james7x1/CPGR4233-PCB-Project/README.md

# CPGR4233-PCB-Project
Voltmeter PCB design project for LeTourneau University CPGR4233.

Derived from 20+ years of PCB designs created by Intro to Microcomputer Design TAs.
Recent Contributors:

Rev 5 - Samuel Johnson, Allen Morrison, Joshua Allen (AJ)

Rev 4 - Samuel Johnson

Rev 3 - Jackson Miller
