james7x1/CPGR4233-PCB-Project/Fabrication/V4/Schematic.pdf

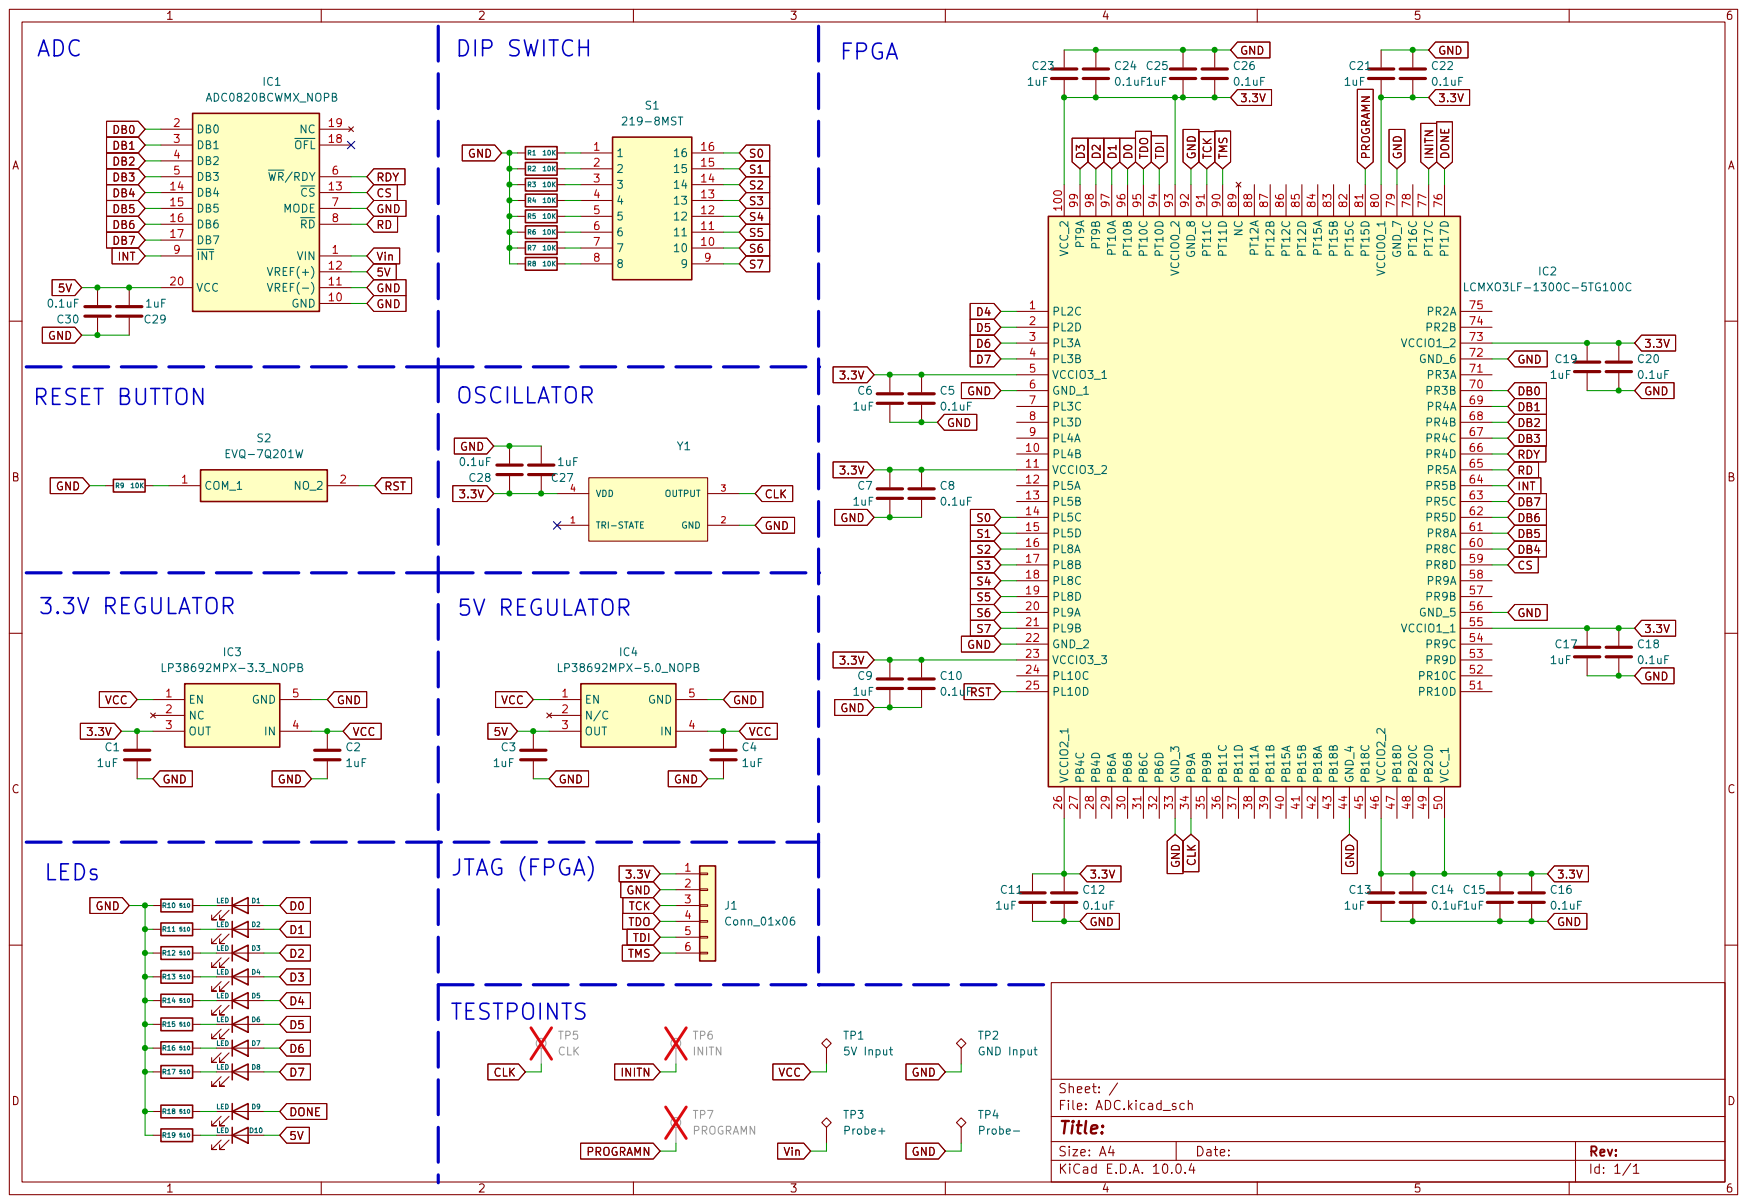
[picture p1: page 1]
