james7x1/CPGR4233-PCB-Project/ADC.kicad_pcb

## KiCad design ADC.kicad_pcb (2026-09-28)

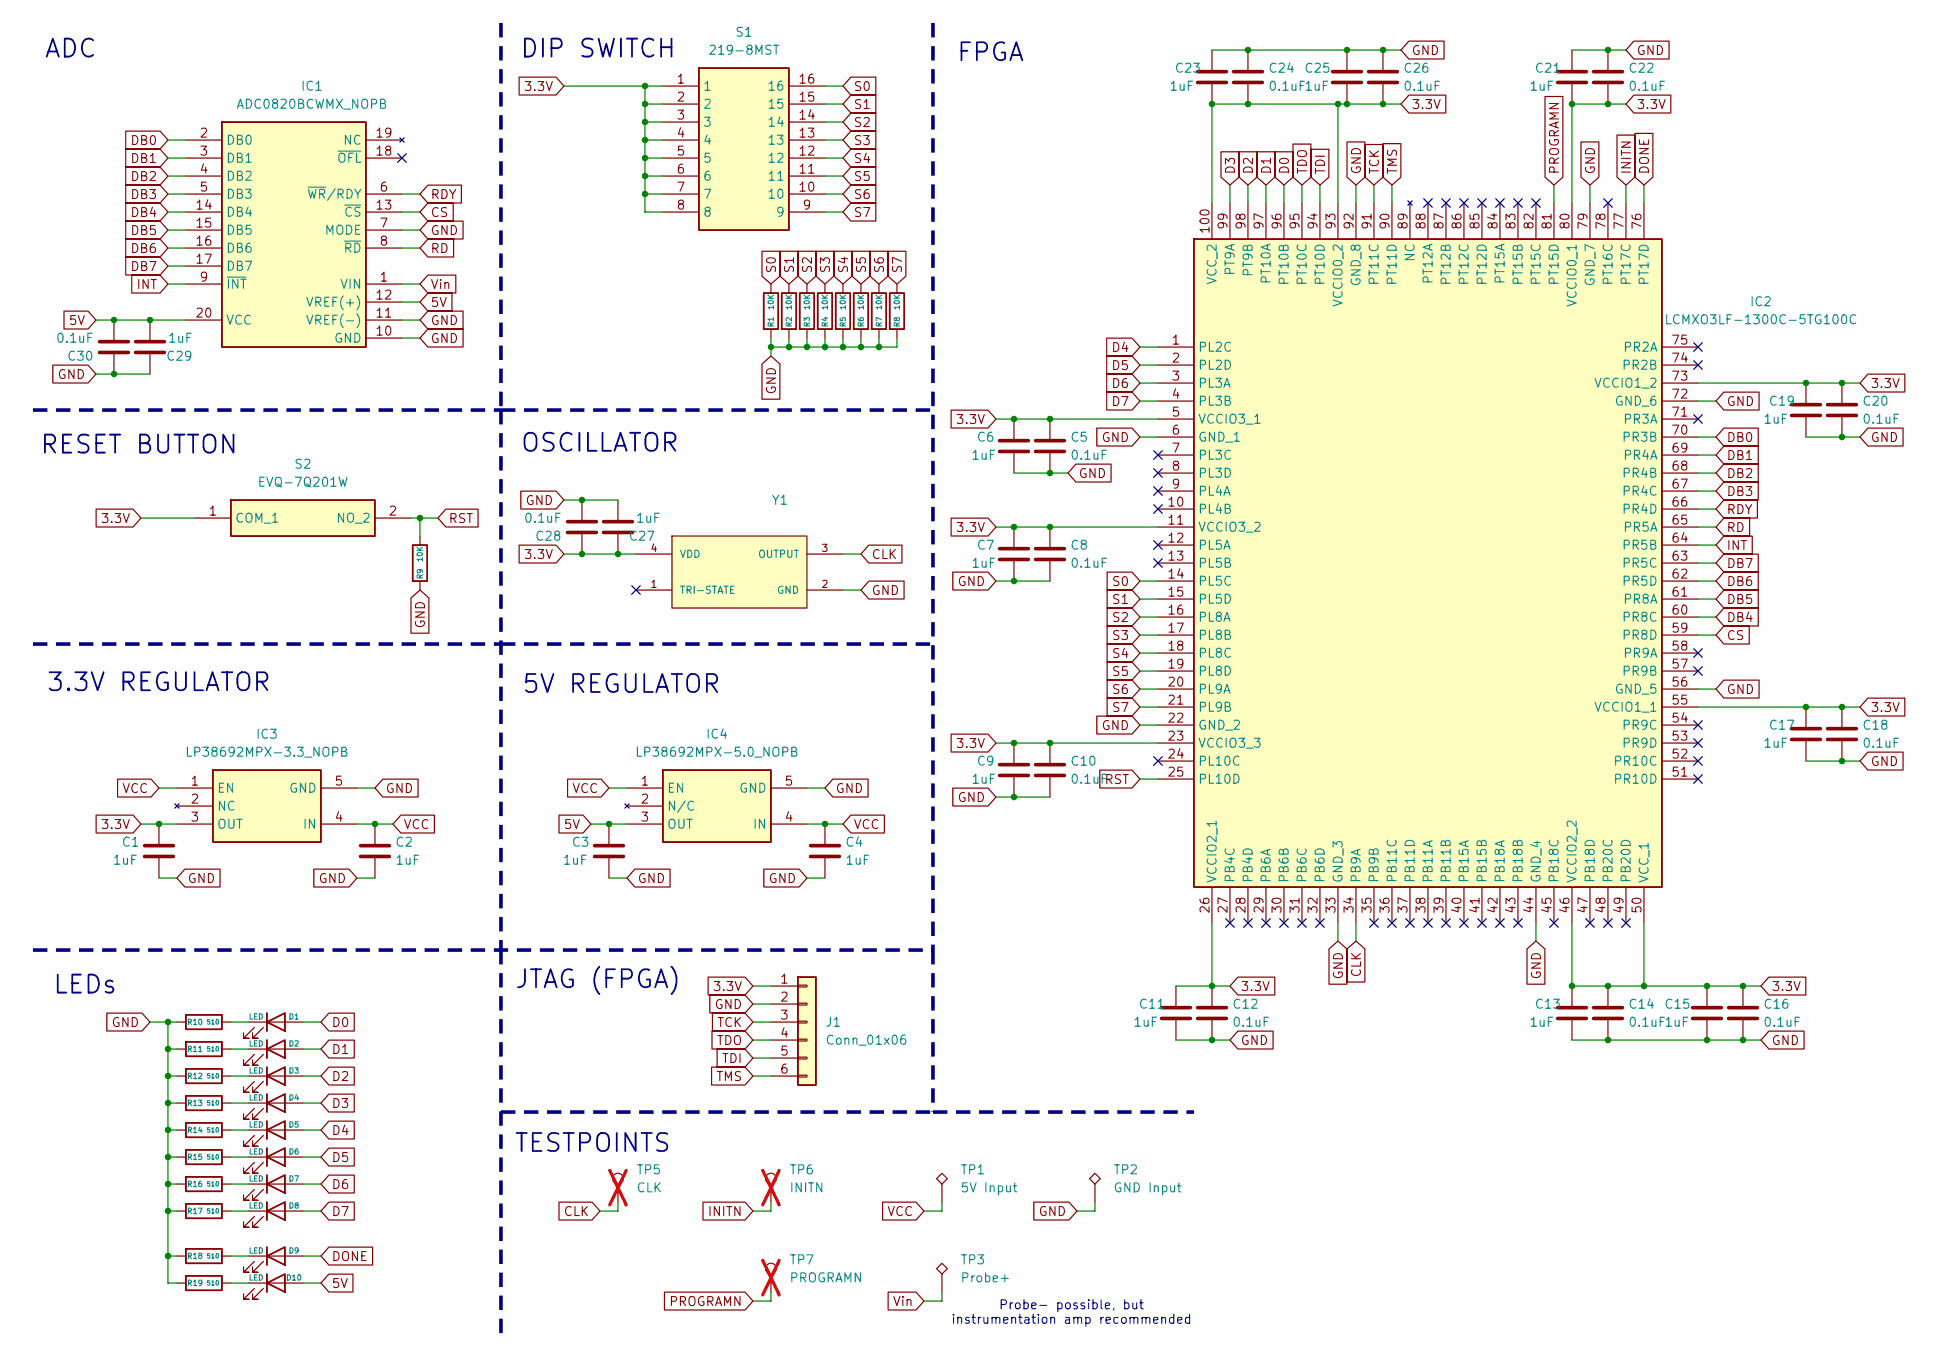
[picture p2: schematic ADC.kicad_sch, CPGR4233 Voltmeter Project]

Parts:
C1, C2, C3, C4, C6, C7, C9, C11, C13, C15, C17, C19, C21, C23, C25, C27, C29: 1uF; C_0805_2012Metric_Pad1.18x1.45mm_HandSolder; Manufacturer_Part_Number GRM21BR71A105MA01L
C5, C8, C10, C12, C14, C16, C18, C20, C22, C24, C26, C28, C30: 0.1uF; C_0805_2012Metric_Pad1.18x1.45mm_HandSolder; Manufacturer_Part_Number GJ4216C81E104JA01D
D1, D2, D3, D4, D5, D6, D7, D8, D9, D10: LED; LED_0805_2012Metric_Pad1.15x1.40mm_HandSolder; Manufacturer_Part_Number 150080GS75000
IC1: ADC0820BCWMX_NOPB; SOIC-20W_7.5x12.8mm_P1.27mm; Mouser Part Number 926-ADC0820BCWMXNOPB
IC2: LCMXO3LF-1300C-5TG100C; TQFP-100_14x14mm_P0.5mm; Mouser Part Number 842-O3LF1300C5TG100C
IC3: LP38692MPX-3.3_NOPB; SOT-223-5; Mouser Part Number 926-LP38692MPX33NOPB
IC4: LP38692MPX-5.0_NOPB; SOT-223-5; Mouser Part Number 926-LP38692MPX50NOPB
J1: Conn_01x06; PinHeader_1x06_P2.54mm_Vertical; Manufacturer_Part_Number G800W302018EU
R1, R2, R3, R4, R5, R6, R7, R8, R9: 10K; R_0805_2012Metric_Pad1.20x1.40mm_HandSolder; Manufacturer_Part_Number AC0805FR-7W10KL
R10, R11, R12, R13, R14, R15, R16, R17, R18, R19: 510; R_0805_2012Metric_Pad1.20x1.40mm_HandSolder; Manufacturer_Part_Number ERJ-PB6D5100V
S1: 219-8MST; SW_DIP_SPSTx08_Slide_6.7x21.88mm_W8.61mm_P2.54mm_LowProfile; Mouser Part Number 774-2198MST
S2: EVQ-7Q201W; SW_SPST_EVQQ2; Mouser Part Number 667-EVQ-7Q201W
TP1: 5V Input; TestPoint_THTPad_2.5x2.5mm_Drill1.2mm; Manufacturer_Part_Number 4952
TP2: GND Input; TestPoint_THTPad_2.5x2.5mm_Drill1.2mm; Manufacturer_Part_Number 4952
TP3: Probe+; TestPoint_THTPad_2.5x2.5mm_Drill1.2mm; Manufacturer_Part_Number 4952
TP5: CLK; TestPoint_Pad_1.5x1.5mm; not fitted
TP6: INITN; TestPoint_Pad_1.5x1.5mm; not fitted
TP7: PROGRAMN; TestPoint_Pad_1.5x1.5mm; not fitted
Y1: CDFN-4_3.2x5mm_P2.54mm; Manufacturer_Part_Number ECS-5032MV-320-BN-TR

Connections:
3.3V: C1.1, C5.1, C6.1, C7.1, C8.1, C9.1, C10.1, C11.1, C12.1, C13.1, C14.1, C15.1, C16.1, C17.1, C18.1, C19.1, C20.1, C21.2, C22.2, C23.2, C24.2, C25.2, C26.2, C27.1, C28.1, IC2.5 (VCCIO3_1), IC2.11 (VCCIO3_2), IC2.23 (VCCIO3_3), IC2.26 (VCCIO2_1), IC2.46 (VCCIO2_2), IC2.50 (VCC_1), IC2.55 (VCCIO1_1), IC2.73 (VCCIO1_2), IC2.80 (VCCIO0_1), IC2.93 (VCCIO0_2), IC2.100 (VCC_2), IC3.3 (OUT), J1.1, S1.1, S1.2, S1.3, S1.4, S1.5, S1.6, S1.7, S1.8, S2.1 (COM_1), Y1.4 (VDD)
5V: C3.1, C29.2, C30.2, D10.2 (A), IC1.12 (VREF(+)), IC1.20 (VCC), IC4.3 (OUT)
CLK: IC2.34 (PB9A), TP5.1 (1_1), Y1.3 (OUTPUT)
CS: IC1.13 (~CS), IC2.59 (PR8D)
D0: D1.2 (A), IC2.96 (PT10B)
D1: D2.2 (A), IC2.97 (PT10A)
D2: D3.2 (A), IC2.98 (PT9B)
D3: D4.2 (A), IC2.99 (PT9A)
D4: D5.2 (A), IC2.1 (PL2C)
D5: D6.2 (A), IC2.2 (PL2D)
D6: D7.2 (A), IC2.3 (PL3A)
D7: D8.2 (A), IC2.4 (PL3B)
DB0: IC1.2 (DB0), IC2.70 (PR3B)
DB1: IC1.3 (DB1), IC2.69 (PR4A)
DB2: IC1.4 (DB2), IC2.68 (PR4B)
DB3: IC1.5 (DB3), IC2.67 (PR4C)
DB4: IC1.14 (DB4), IC2.60 (PR8C)
DB5: IC1.15 (DB5), IC2.61 (PR8A)
DB6: IC1.16 (DB6), IC2.62 (PR5D)
DB7: IC1.17 (DB7), IC2.63 (PR5C)
DONE: D9.2 (A), IC2.76 (PT17D)
GND: C1.2, C2.2, C3.2, C4.2, C5.2, C6.2, C7.2, C8.2, C9.2, C10.2, C11.2, C12.2, C13.2, C14.2, C15.2, C16.2, C17.2, C18.2, C19.2, C20.2, C21.1, C22.1, C23.1, C24.1, C25.1, C26.1, C27.2, C28.2, C29.1, C30.1, IC1.7 (MODE), IC1.10 (GND), IC1.11 (VREF(-)), IC2.6 (GND_1), IC2.22 (GND_2), IC2.33 (GND_3), IC2.44 (GND_4), IC2.56 (GND_5), IC2.72 (GND_6), IC2.79 (GND_7), IC2.92 (GND_8), IC3.5 (GND), IC4.5 (GND), J1.2, R1.2, R2.2, R3.2, R4.2, R5.2, R6.2, R7.2, R8.2, R9.2, R10.2, R11.2, R12.2, R13.2, R14.2, R15.2, R16.2, R17.2, R18.2, R19.2, TP2.1 (1_1), Y1.2 (GND)
INITN: IC2.77 (PT17C), TP6.1 (1_1)
INT: IC1.9 (~INT), IC2.64 (PR5B)
unnamed: D1.1 (K), R10.1
unnamed: D2.1 (K), R11.1
unnamed: D3.1 (K), R12.1
unnamed: D4.1 (K), R13.1
unnamed: D5.1 (K), R14.1
unnamed: D6.1 (K), R15.1
unnamed: D7.1 (K), R16.1
unnamed: D8.1 (K), R17.1
unnamed: D9.1 (K), R18.1
unnamed: D10.1 (K), R19.1
PROGRAMN: IC2.81 (PT15D), TP7.1 (1_1)
RD: IC1.8 (~RD), IC2.65 (PR5A)
RDY: IC1.6 (~WR/RDY), IC2.66 (PR4D)
RST: IC2.25 (PL10D), R9.1, S2.2 (NO_2)
S0: IC2.14 (PL5C), R1.1, S1.16
S1: IC2.15 (PL5D), R2.1, S1.15
S2: IC2.16 (PL8A), R3.1, S1.14
S3: IC2.17 (PL8B), R4.1, S1.13
S4: IC2.18 (PL8C), R5.1, S1.12
S5: IC2.19 (PL8D), R6.1, S1.11
S6: IC2.20 (PL9A), R7.1, S1.10
S7: IC2.21 (PL9B), R8.1, S1.9
TCK: IC2.91 (PT11C), J1.3
TDI: IC2.94 (PT10D), J1.5
TDO: IC2.95 (PT10C), J1.4
TMS: IC2.90 (PT11D), J1.6
VCC: C2.1, C4.1, IC3.1 (EN), IC3.4 (IN), IC4.1 (EN), IC4.4 (IN), TP1.1 (1_1)
Vin: IC1.1 (VIN), TP3.1 (1_1)

Notes on the sheet:
LEDs
DIP SWITCH
3.3V REGULATOR
Probe- possible, but instrumentation amp recommended
RESET BUTTON
5V REGULATOR
JTAG (FPGA)
OSCILLATOR
ADC
FPGA
TESTPOINTS

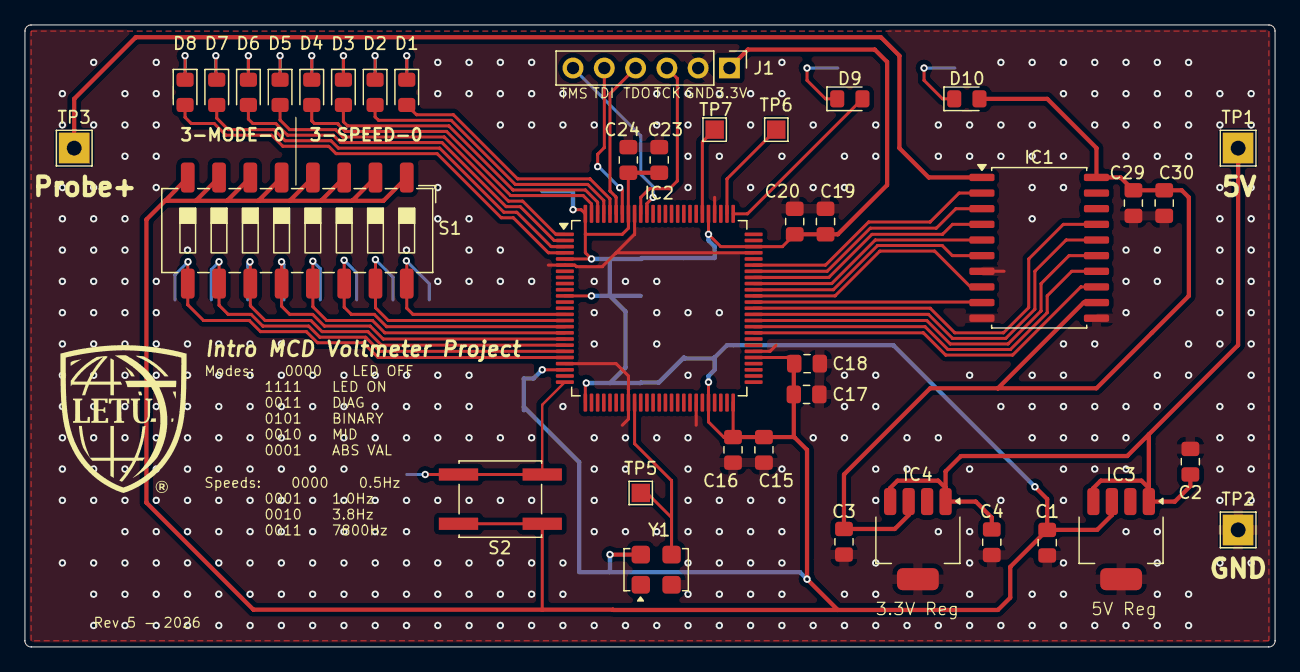
[picture p3: board ADC.kicad_pcb from above]

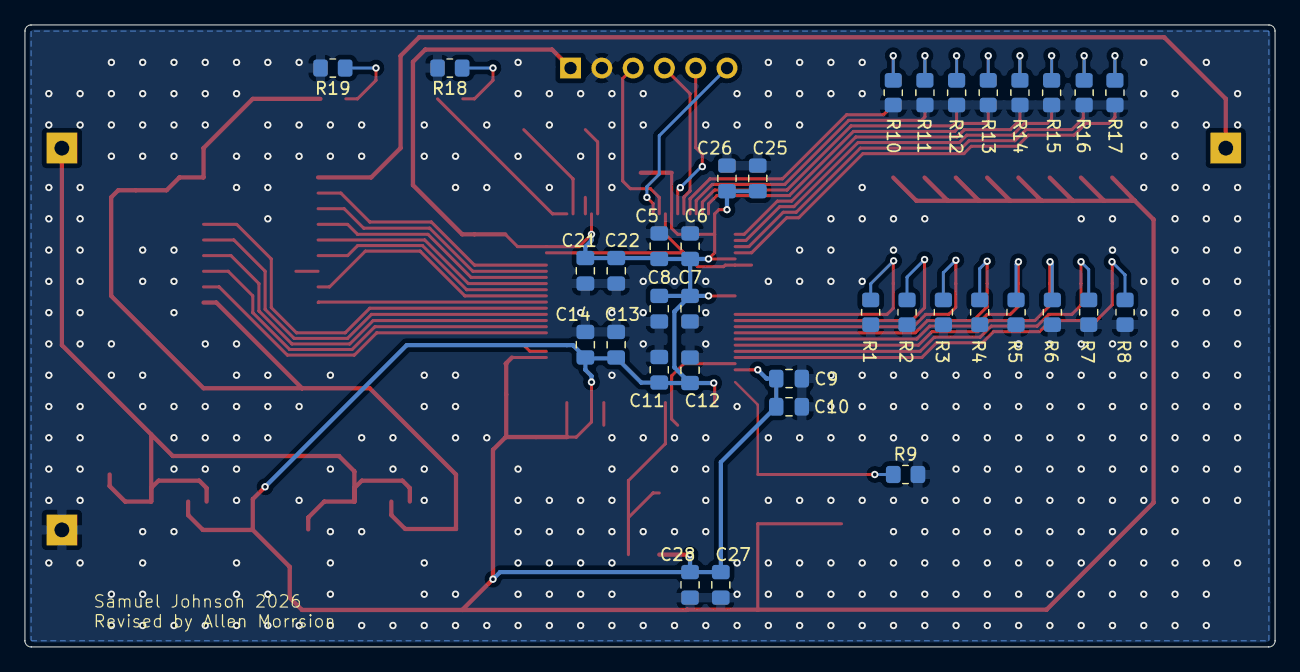
[picture p4: board ADC.kicad_pcb from below]

Board: 2 copper layers, 101.5 x 50.5 mm, 73 parts (35 on the bottom side), 52 nets.
