james7x1/CPGR4233-PCB-Project/(commit log)

2026-09-24 Uploaded Samuel Johnson's Rev 4. This board has errors in the switch circuit that prevents setting speed and mode on FPGA.
    [ADC-B_Cu.gbr, ADC-B_Mask.gbr, ADC-B_Paste.gbr, ADC-B_Silkscreen.gbr, ADC-Edge_Cuts.gbr, ADC-F_Cu.gbr, ADC-F_Mask.gbr, ADC-F_Paste.gbr]
2026-09-24 Added BOM for Rev 4
    [BOM.csv]
2026-09-24 Start of Rev 5. Mimic'd the operation of Rev 3 where 3.3V goes to one side of the switches and a pulldown resistor bank is used on the FPGA input lines. Fixing ERC errors
    [ADC.kicad_pcb, ADC.kicad_sch]
2026-09-24 Re-created schematic library
    [ADC.kicad_sch]
2026-09-24 Routed resistors for switch bank. Need to clear DRC
    [ADC.kicad_pcb]
2026-09-25 Completed modifications. Ready for review
    [ADC.kicad_pcb, ADC.kicad_sch]
2026-09-25 Generated fabrication files and moved a few components to pass JLCPCB DFM check
    [ADC.kicad_pcb, ADC.kicad_sch]
2026-09-28 Rewired reset switch to toggle between grounded reset pin and VCC. Corrected some symbol errors
    [ADC-B_Cu.gbl, ADC-B_Mask.gbs, ADC-B_Paste.gbp, ADC-B_Silkscreen.gbo, ADC-Edge_Cuts.gm1, ADC-F_Cu.gtl, ADC-F_Mask.gts, ADC-F_Paste.gtp]
